adamcatley/LAZEY-Projector/Hardware/hardware.txt

Files related to hardware for the project.
eg. schematics and baord designs
