adamcatley/LAZEY-Projector/Hardware/Controller/sch.brd

## EAGLE design Hardware/Controller/sch.brd (2014-09-18)

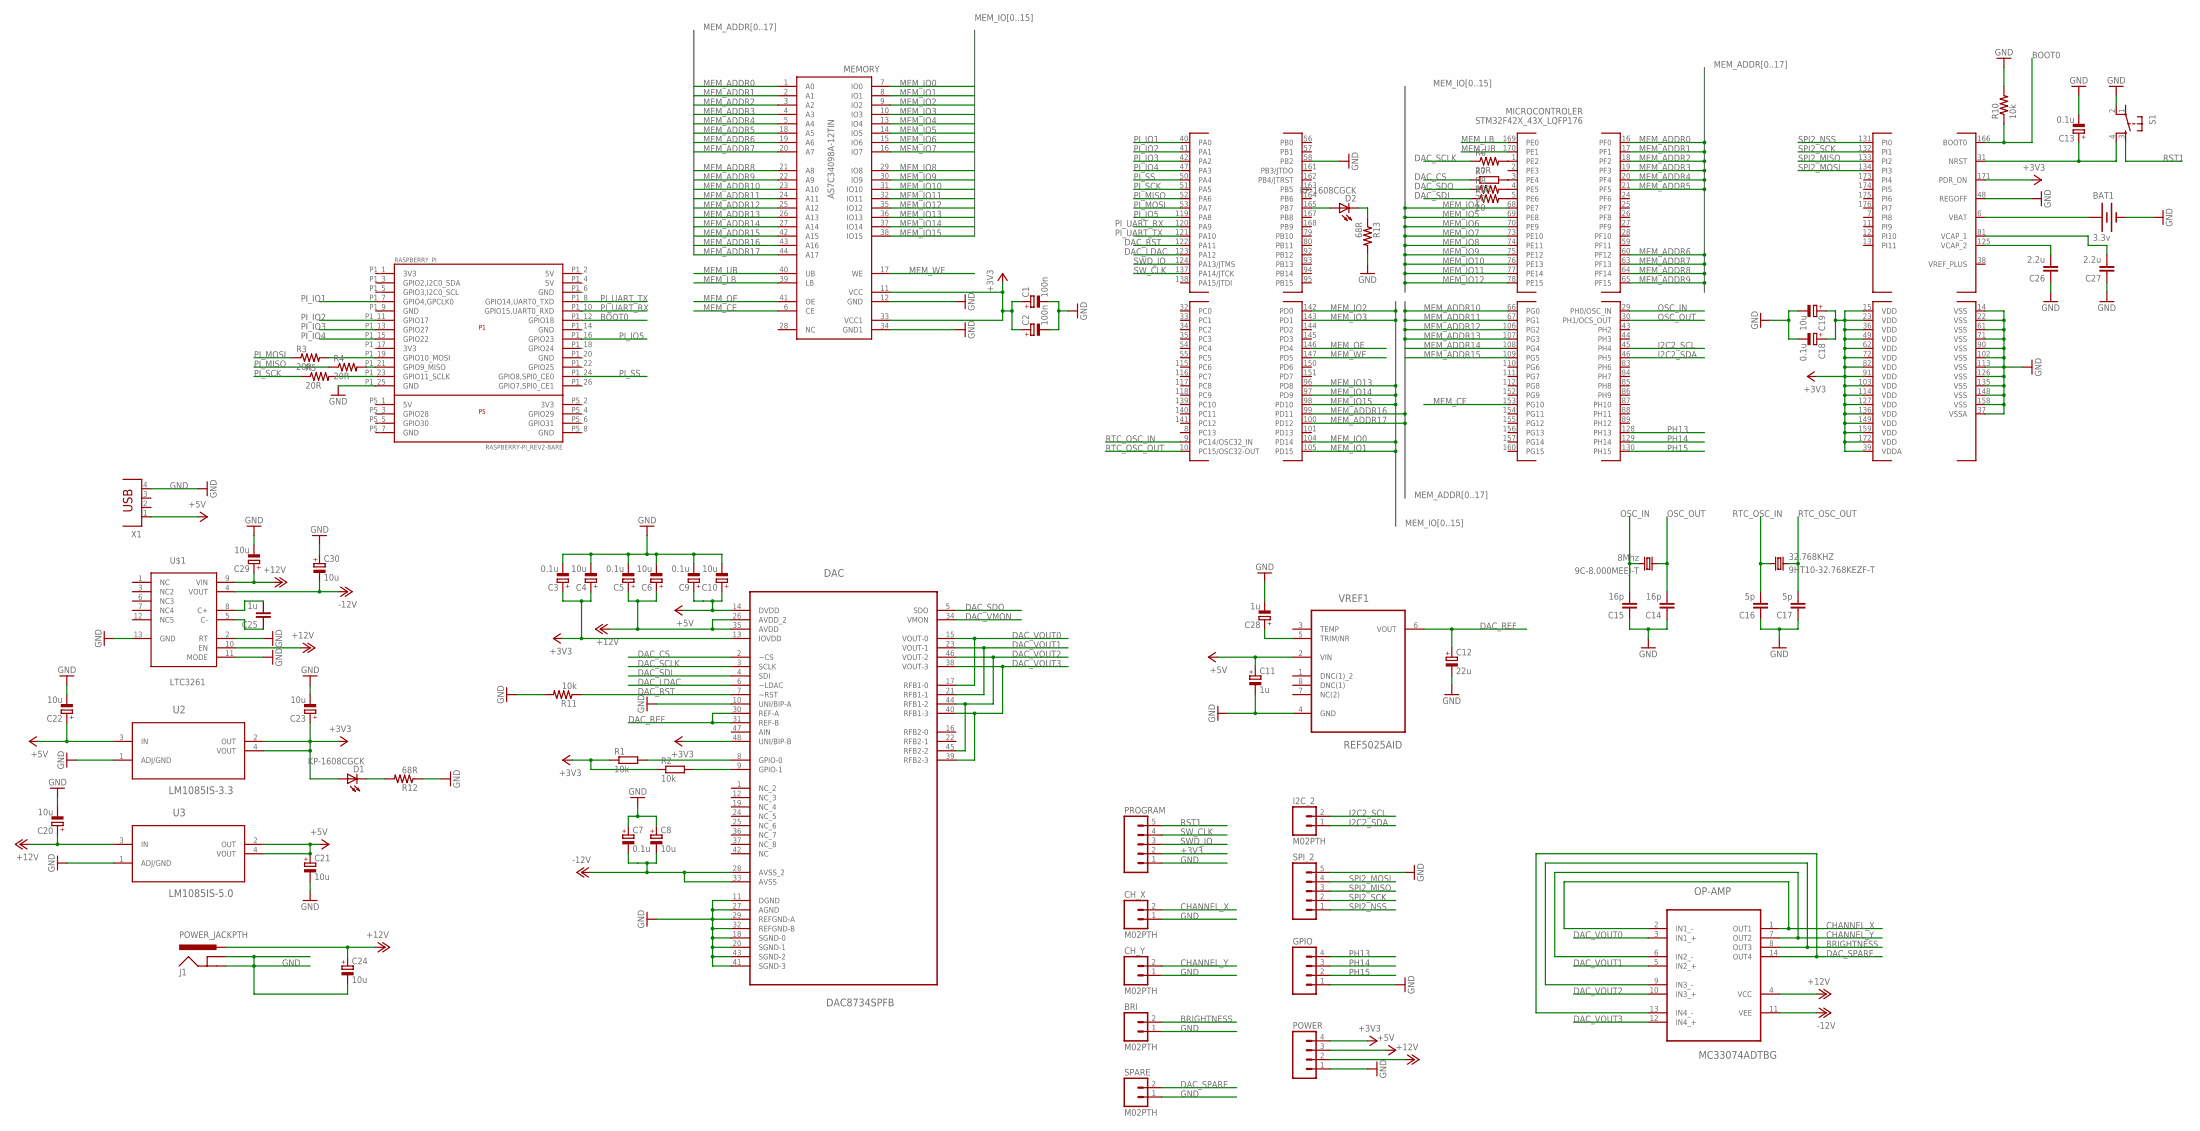
[picture p1: schematic sch.sch]

Parts:
9C-8.000MEEJ-T: 8Mhz; CSM-7X-DU
32.768KHZ: 9HT10-32.768KEZF-T
BAT1: 3.3v; BATTCON_12MM
BRI: M02PTH; 1X02
C1, C2: 100n; SMC_A
C3, C5, C7, C9, C13, C18: 0.1u; SMC_A
C4, C6, C8, C10, C19, C20, C21, C22, C23, C24, C29, C30: 10u; SMC_A
C11, C28: 1u; SMC_A
C12: 22u; SMC_A
C14, C15: 16p; C0603
C16, C17: 5p; C0603
C25: 1u; C0603
C26, C27: 2.2u; C0603
CH_X: M02PTH; 1X02
CH_Y: M02PTH; 1X02
D1, D2: KP-1608CGCK; LED-0603
DAC: DAC8734SPFB; QFP50P900X900X120-48N
GPIO: M04PTH; 1X04
I2C_2: M02PTH; 1X02
J1: POWER_JACKPTH; POWER_JACK_PTH
MEMORY: AS7C34098A-12TIN; TSOPII-44
MICROCONTROLER: STM32F42X_43X_LQFP176; LQFP176_PACKAGE
OP-AMP: MC33074ADTBG; SOP65P640X120-14N
POWER: M04PTH; 1X04
PROGRAM: M05PTH; 1X05
R1, R2: 10k; R0805
R3, R4, R5, R6: 20R; 0603-RES
R7: 20R; R0603
R8, R9: 20; 0603-RES
R10, R11: 10k; 0603-RES
R12, R13: 68R; 0603-RES
RASPBERRY_PI: RASPBERRY-PI_REV2-BARE
S1: TAC_SWITCHSMD; TACTILE_SWITCH_SMD
SPARE: M02PTH; 1X02
SPI_2: M05PTH; 1X05
U2: LM1085IS-3.3; TO254P1435X457-3N
U3: LM1085IS-5.0; TO254P1435X457-3N
U$1: LTC3261; MSOP12
VREF1: REF5025AID; SOIC127P600X175-8N
X1: PN87520

Connections:
+3V3: C1.+, C2.+, C3.+, C4.+, C18.+, C19.+, C23.+, D1.A, DAC.13 (IOVDD), DAC.48 (UNI/BIP-B), MEMORY.11 (VCC), MEMORY.33 (VCC1), MICROCONTROLER.15 (VDD), MICROCONTROLER.23 (VDD), MICROCONTROLER.36 (VDD), MICROCONTROLER.39 (VDDA), MICROCONTROLER.49 (VDD), MICROCONTROLER.62 (VDD), MICROCONTROLER.72 (VDD), MICROCONTROLER.82 (VDD), MICROCONTROLER.91 (VDD), MICROCONTROLER.103 (VDD), MICROCONTROLER.114 (VDD), MICROCONTROLER.127 (VDD), MICROCONTROLER.136 (VDD), MICROCONTROLER.149 (VDD), MICROCONTROLER.159 (VDD), MICROCONTROLER.171 (PDR_ON), MICROCONTROLER.172 (VDD), POWER.4, PROGRAM.2, R1.1, R2.1, U2.2 (OUT), U2.4 (VOUT)
+5V: C9.+, C10.+, C11.+, C21.+, C22.+, DAC.14 (DVDD), POWER.3, U2.3 (IN), U3.2 (OUT), U3.4 (VOUT), VREF1.2 (VIN), X1.1
+12V: C5.+, C6.+, C20.+, C24.+, C29.+, DAC.26 (AVDD_2), DAC.35 (AVDD), J1.PWR, OP-AMP.4 (VCC), POWER.2, U3.3 (IN), U$1.9 (VIN), U$1.10 (EN)
-12V: C7.-, C8.-, C30.-, DAC.28 (AVSS_2), DAC.33 (AVSS), OP-AMP.11 (VEE), U$1.4 (VOUT)
BOOT0: MICROCONTROLER.166 (BOOT0), R10.1, RASPBERRY_PI.P1_12 (GPIO18)
BRIGHTNESS: BRI.2, OP-AMP.8 (OUT3), OP-AMP.9 (IN3_-)
CHANNEL_X: CH_X.2, OP-AMP.1 (OUT1), OP-AMP.2 (IN1_-)
CHANNEL_Y: CH_Y.2, OP-AMP.6 (IN2_-), OP-AMP.7 (OUT2)
DAC_CS: DAC.2 (~CS), R7.1
DAC_LDAC: DAC.6 (~LDAC), MICROCONTROLER.123 (PA12)
DAC_REF: C12.+, DAC.30 (REF-A), DAC.31 (REF-B), VREF1.6 (VOUT)
DAC_RST: DAC.7 (~RST), MICROCONTROLER.122 (PA11), R11.1
DAC_SCLK: DAC.3 (SCLK), R6.1
DAC_SDI: DAC.4 (SDI), R9.1
DAC_SDO: DAC.5 (SDO), R8.1
DAC_SPARE: OP-AMP.13 (IN4_-), OP-AMP.14 (OUT4), SPARE.2
DAC_VMON: DAC.34 (VMON)
DAC_VOUT0: DAC.15 (VOUT-0), DAC.17 (RFB1-0), OP-AMP.3 (IN1_+)
DAC_VOUT1: DAC.21 (RFB1-1), DAC.23 (VOUT-1), OP-AMP.5 (IN2_+)
DAC_VOUT2: DAC.44 (RFB1-2), DAC.45 (RFB2-2), DAC.46 (VOUT-2), OP-AMP.10 (IN3_+)
DAC_VOUT3: DAC.38 (VOUT-3), DAC.39 (RFB2-3), DAC.40 (RFB1-3), OP-AMP.12 (IN4_+)
GND: BAT1.GND (-), BRI.1, C1.-, C2.-, C3.-, C4.-, C5.-, C6.-, C7.+, C8.+, C9.-, C10.-, C11.-, C12.-, C13.-, C14.1, C15.1, C16.1, C17.1, C18.-, C19.-, C20.-, C21.-, C22.-, C23.-, C24.-, C26.1, C27.1, C28.-, C29.-, C30.+, CH_X.1, CH_Y.1, DAC.10 (UNI/BIP-A), DAC.11 (DGND), DAC.18 (SGND-0), DAC.20 (SGND-1), DAC.27 (AGND), DAC.29 (REFGND-A), DAC.32 (REFGND-B), DAC.41 (SGND-3), DAC.43 (SGND-2), GPIO.1, J1.GND, J1.GNDBREAK, MEMORY.12 (GND), MEMORY.34 (GND1), MICROCONTROLER.14 (VSS), MICROCONTROLER.22 (VSS), MICROCONTROLER.37 (VSSA), MICROCONTROLER.48 (REGOFF), MICROCONTROLER.58 (PB2), MICROCONTROLER.61 (VSS), MICROCONTROLER.71 (VSS), MICROCONTROLER.90 (VSS), MICROCONTROLER.102 (VSS), MICROCONTROLER.113 (VSS), MICROCONTROLER.126 (VSS), MICROCONTROLER.135 (VSS), MICROCONTROLER.148 (VSS), MICROCONTROLER.158 (VSS), POWER.1, PROGRAM.1, R10.2, R11.2, R12.1, R13.2, RASPBERRY_PI.P1_25 (GND), S1.2, SPARE.1, SPI_2.5, U2.1 (ADJ/GND), U3.1 (ADJ/GND), U$1.2 (RT), U$1.11 (MODE), U$1.13 (GND), VREF1.4 (GND), X1.4
I2C2_SCL: I2C_2.2, MICROCONTROLER.45 (PH4)
I2C2_SDA: I2C_2.1, MICROCONTROLER.46 (PH5)
MEM_ADDR0: MEMORY.1 (A0), MICROCONTROLER.16 (PF0)
MEM_ADDR1: MEMORY.2 (A1), MICROCONTROLER.17 (PF1)
MEM_ADDR2: MEMORY.3 (A2), MICROCONTROLER.18 (PF2)
MEM_ADDR3: MEMORY.4 (A3), MICROCONTROLER.19 (PF3)
MEM_ADDR4: MEMORY.5 (A4), MICROCONTROLER.20 (PF4)
MEM_ADDR5: MEMORY.18 (A5), MICROCONTROLER.21 (PF5)
MEM_ADDR6: MEMORY.19 (A6), MICROCONTROLER.60 (PF12)
MEM_ADDR7: MEMORY.20 (A7), MICROCONTROLER.63 (PF13)
MEM_ADDR8: MEMORY.21 (A8), MICROCONTROLER.64 (PF14)
MEM_ADDR9: MEMORY.22 (A9), MICROCONTROLER.65 (PF15)
MEM_ADDR10: MEMORY.23 (A10), MICROCONTROLER.66 (PG0)
MEM_ADDR11: MEMORY.24 (A11), MICROCONTROLER.67 (PG1)
MEM_ADDR12: MEMORY.25 (A12), MICROCONTROLER.106 (PG2)
MEM_ADDR13: MEMORY.26 (A13), MICROCONTROLER.107 (PG3)
MEM_ADDR14: MEMORY.27 (A14), MICROCONTROLER.108 (PG4)
MEM_ADDR15: MEMORY.42 (A15), MICROCONTROLER.109 (PG5)
MEM_ADDR16: MEMORY.43 (A16), MICROCONTROLER.99 (PD11)
MEM_ADDR17: MEMORY.44 (A17), MICROCONTROLER.100 (PD12)
MEM_CE: MEMORY.6 (CE), MICROCONTROLER.153 (PG10)
MEM_IO0: MEMORY.7 (IO0), MICROCONTROLER.104 (PD14)
MEM_IO1: MEMORY.8 (IO1), MICROCONTROLER.105 (PD15)
MEM_IO2: MEMORY.9 (IO2), MICROCONTROLER.142 (PD0)
MEM_IO3: MEMORY.10 (IO3), MICROCONTROLER.143 (PD1)
MEM_IO4: MEMORY.13 (IO4), MICROCONTROLER.68 (PE7)
MEM_IO5: MEMORY.14 (IO5), MICROCONTROLER.69 (PE8)
MEM_IO6: MEMORY.15 (IO6), MICROCONTROLER.70 (PE9)
MEM_IO7: MEMORY.16 (IO7), MICROCONTROLER.73 (PE10)
MEM_IO8: MEMORY.29 (IO8), MICROCONTROLER.74 (PE11)
MEM_IO9: MEMORY.30 (IO9), MICROCONTROLER.75 (PE12)
MEM_IO10: MEMORY.31 (IO10), MICROCONTROLER.76 (PE13)
MEM_IO11: MEMORY.32 (IO11), MICROCONTROLER.77 (PE14)
MEM_IO12: MEMORY.35 (IO12), MICROCONTROLER.78 (PE15)
MEM_IO13: MEMORY.36 (IO13), MICROCONTROLER.96 (PD8)
MEM_IO14: MEMORY.37 (IO14), MICROCONTROLER.97 (PD9)
MEM_IO15: MEMORY.38 (IO15), MICROCONTROLER.98 (PD10)
MEM_LB: MEMORY.39 (LB), MICROCONTROLER.169 (PE0)
MEM_OE: MEMORY.41 (OE), MICROCONTROLER.146 (PD4)
MEM_UB: MEMORY.40 (UB), MICROCONTROLER.170 (PE1)
MEM_WE: MEMORY.17 (WE), MICROCONTROLER.147 (PD5)
unnamed: DAC.8 (GPIO-0), R1.2
unnamed: DAC.9 (GPIO-1), R2.2
unnamed: D1.C, R12.2
unnamed: D2.A, MICROCONTROLER.165 (PB7)
unnamed: R3.2, RASPBERRY_PI.P1_19 (GPIO10_MOSI)
unnamed: C25.2, U$1.8 (C+)
unnamed: R4.2, RASPBERRY_PI.P1_21 (GPIO9_MISO)
unnamed: R5.2, RASPBERRY_PI.P1_23 (GPIO11_SCLK)
unnamed: MICROCONTROLER.5 (PE6), R9.2
unnamed: MICROCONTROLER.4 (PE5), R8.2
unnamed: MICROCONTROLER.3 (PE4), R7.2
unnamed: MICROCONTROLER.1 (PE2), R6.2
unnamed: C25.1, U$1.5 (C-)
unnamed: D2.C, R13.1
unnamed: C26.2, MICROCONTROLER.125 (VCAP_2)
unnamed: C27.2, MICROCONTROLER.81 (VCAP_1)
unnamed: C28.+, VREF1.5 (TRIM/NR)
OSC_IN: 9C-8.000MEEJ-T.2, C15.2, MICROCONTROLER.29 (PH0/OSC_IN)
OSC_OUT: 9C-8.000MEEJ-T.1, C14.2, MICROCONTROLER.30 (PH1/OCS_OUT)
PH13: GPIO.4, MICROCONTROLER.128 (PH13)
PH14: GPIO.3, MICROCONTROLER.129 (PH14)
PH15: GPIO.2, MICROCONTROLER.130 (PH15)
PI_IO1: MICROCONTROLER.40 (PA0), RASPBERRY_PI.P1_7 (GPIO4,GPCLK0)
PI_IO2: MICROCONTROLER.41 (PA1), RASPBERRY_PI.P1_11 (GPIO17)
PI_IO3: MICROCONTROLER.42 (PA2), RASPBERRY_PI.P1_13 (GPIO27)
PI_IO4: MICROCONTROLER.47 (PA3), RASPBERRY_PI.P1_15 (GPIO22)
PI_IO5: MICROCONTROLER.119 (PA8), RASPBERRY_PI.P1_16 (GPIO23)
PI_MISO: MICROCONTROLER.52 (PA6), R4.1
PI_MOSI: MICROCONTROLER.53 (PA7), R3.1
PI_SCK: MICROCONTROLER.51 (PA5), R5.1
PI_SS: MICROCONTROLER.50 (PA4), RASPBERRY_PI.P1_24 (GPIO8,SPI0_CE0)
PI_UART_RX: MICROCONTROLER.120 (PA9), RASPBERRY_PI.P1_10 (GPIO15,UART0_RXD)
PI_UART_TX: MICROCONTROLER.121 (PA10), RASPBERRY_PI.P1_8 (GPIO14,UART0_TXD)
RST0: C13.+, MICROCONTROLER.31 (NRST), S1.4
RST1: PROGRAM.5, S1.3
RTC_OSC_IN: 32.768KHZ.P$1 (1), C16.2, MICROCONTROLER.9 (PC14/OSC32_IN)
RTC_OSC_OUT: 32.768KHZ.P$2 (2), C17.2, MICROCONTROLER.10 (PC15/OSC32-OUT)
SPI2_MISO: MICROCONTROLER.133 (PI2), SPI_2.3
SPI2_MOSI: MICROCONTROLER.134 (PI3), SPI_2.4
SPI2_NSS: MICROCONTROLER.131 (PI0), SPI_2.1
SPI2_SCK: MICROCONTROLER.132 (PI1), SPI_2.2
SWD_IO: MICROCONTROLER.124 (PA13/JTMS), PROGRAM.3
SW_CLK: MICROCONTROLER.137 (PA14/JTCK), PROGRAM.4
VBAT: BAT1.PWR@1 (+), MICROCONTROLER.6 (VBAT)

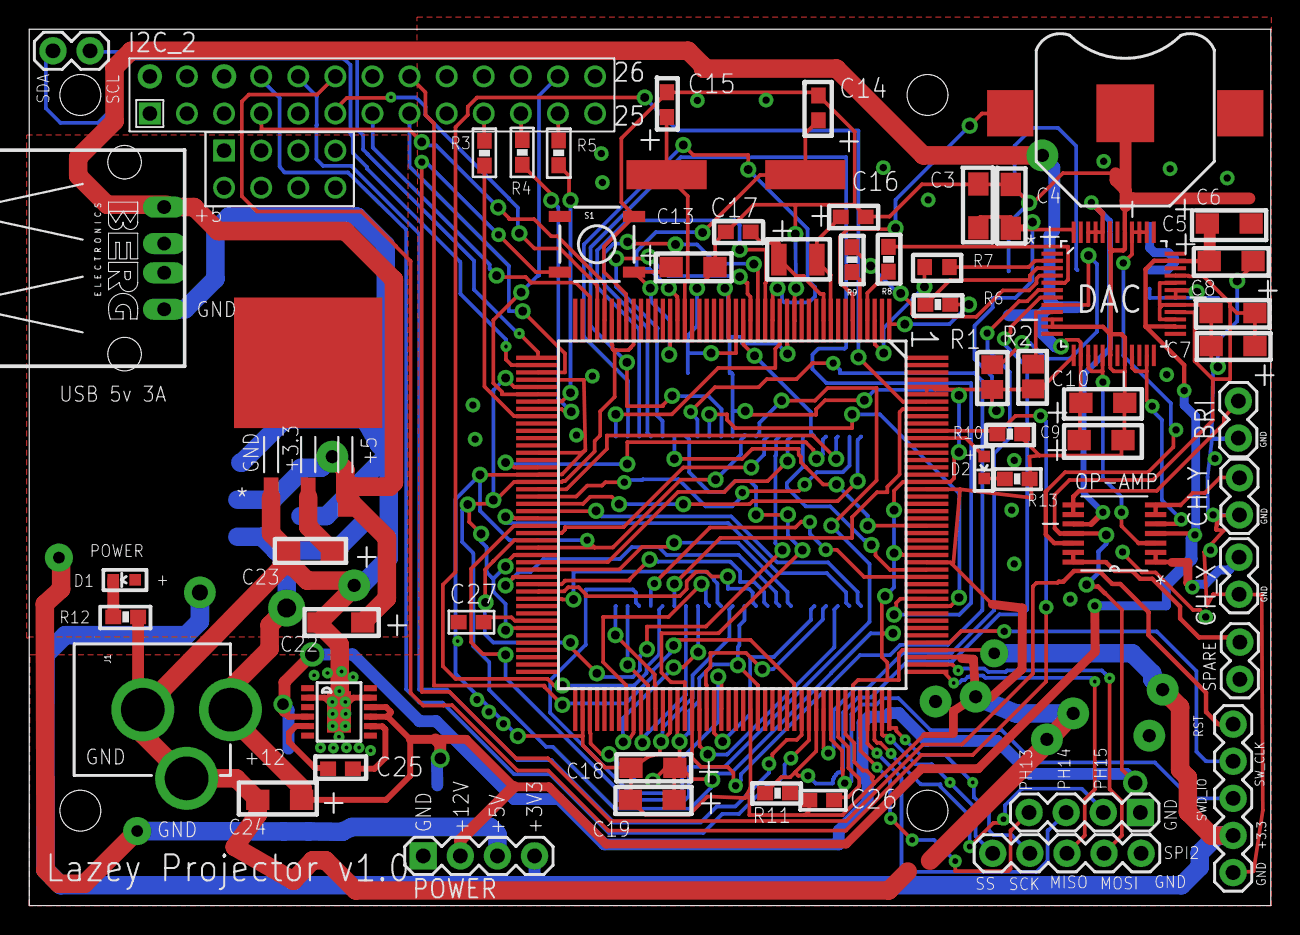
[picture p2: board Hardware/Controller/sch.brd from above]

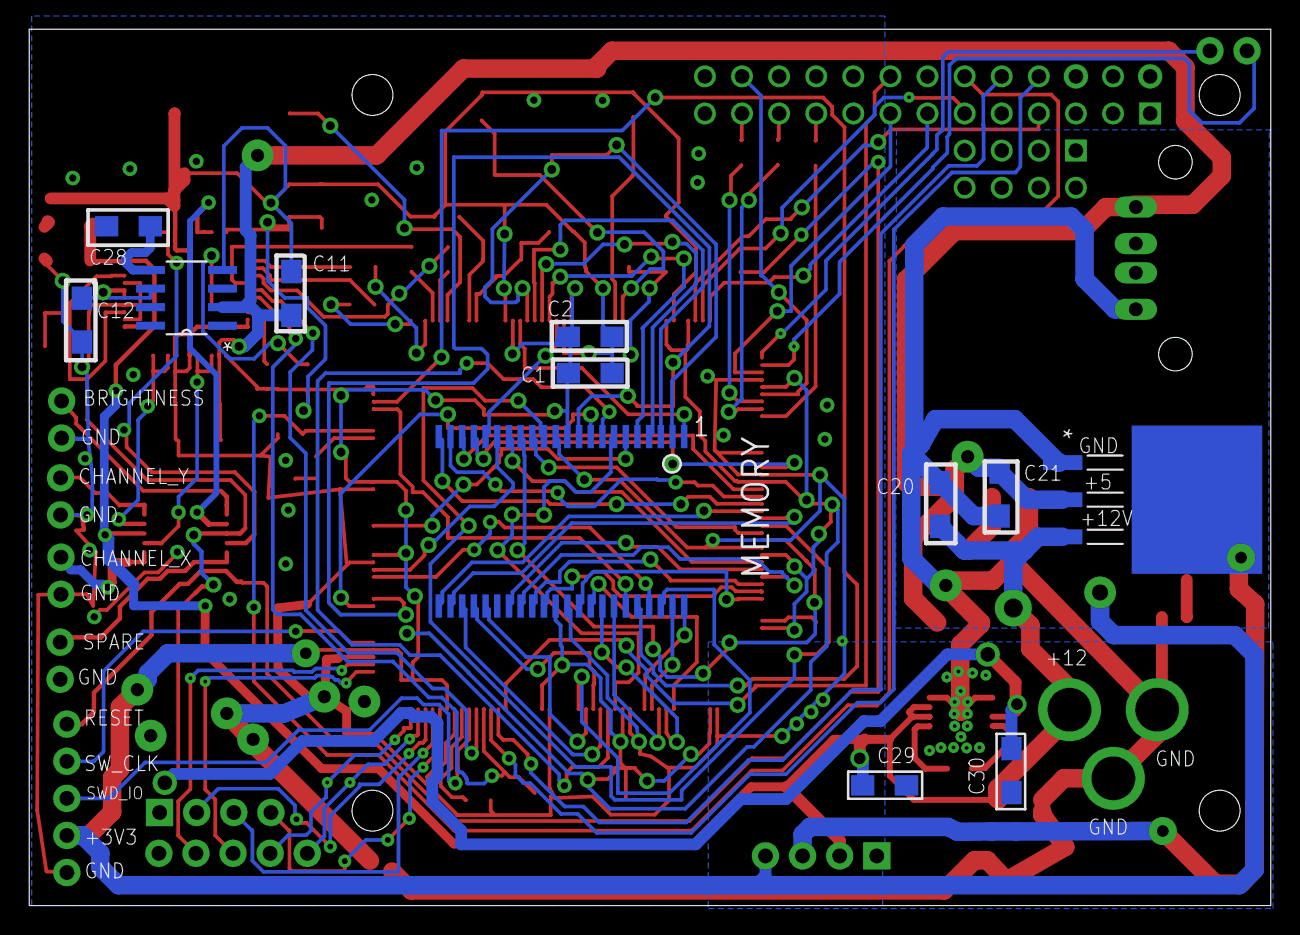
[picture p3: board Hardware/Controller/sch.brd from below]

Board: 2 copper layers, 85.0 x 60.0 mm, 69 parts (12 on the bottom side), 106 nets.
