adamcatley/LAZEY-Projector/Hardware/Laser Driver/Sch.brd

## EAGLE design Hardware/Laser Driver/Sch.brd (2014-09-18, an earlier design)

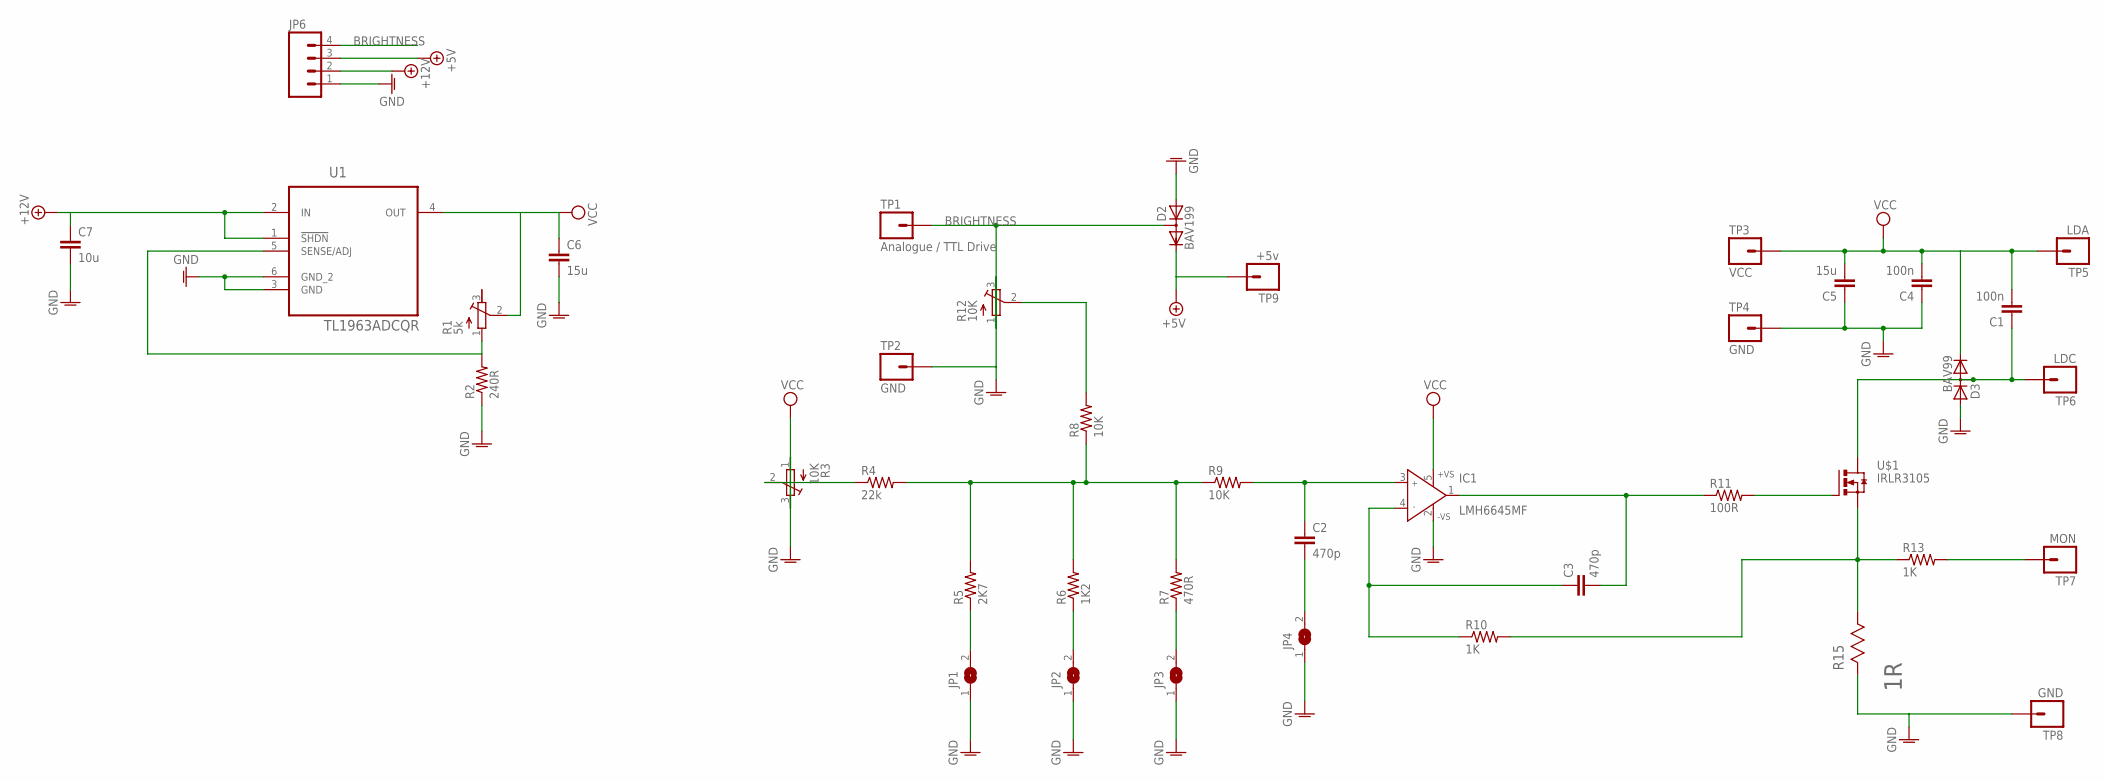
[picture p4: schematic Sch.sch]

Parts:
C1, C4: 100n; 1206
C2, C3: 470p; 1206
C5, C6: 15u; 1206
C7: 10u; 1206
D2: BAV199; SOT23
D3: BAV99; SOT23
IC1: LMH6645MF; SOT23-5
JP1, JP2, JP3, JP4: SJ
JP6: M04PTH; 1X04
R1: 5k; RTRIM64W
R2: 240R; 0603-RES
R3, R12: 10K; RTRIM5X
R4: 22k; 0603-RES
R5: 2K7; 0603-RES
R6: 1K2; 0603-RES
R7: 470R; 0603-RES
R8, R9: 10K; 0603-RES
R10, R13: 1K; 0603-RES
R11: 100R; R0603
R15: 1R; RESC5025X71N
TP1: Analogue / TTL Drive; 1X01
TP2, TP4, TP8: GND; 1X01
TP3: VCC; 1X01
TP5: LDA; 1X01_LONGPAD
TP6: LDC; 1X01_LONGPAD
TP7: MON; 1X01
TP9: +5v; 1X01
U1: TL1963ADCQR; SOT127P700X180-6N
U$1: IRLR3105; TO252AA-LARGE

Connections:
+5V: D2.2 (C), JP6.3, TP9.1
+12V: C7.1, JP6.2, U1.1 (!SHDN), U1.2 (IN)
BRIGHTNESS: D2.3 (AC), JP6.4, R12.1 (E), TP1.1
GNDA: C4.1, C5.1, C6.2, C7.2, D2.1 (A), D3.1 (A), IC1.2 (-VS), JP1.1, JP2.1, JP3.1, JP4.1, JP6.1, R2.1, R3.1 (E), R12.3 (A), R15.2 (R2), TP2.1, TP4.1, TP8.1, U1.3 (GND), U1.6 (GND_2)
unnamed: R8.2, R12.2 (S)
unnamed: R3.2 (S), R4.1
unnamed: R4.2, R5.2, R6.2, R7.2, R8.1, R9.1
unnamed: JP1.2, R5.1
unnamed: JP2.2, R6.1
unnamed: JP3.2, R7.1
unnamed: C2.2, JP4.2
unnamed: C2.1, IC1.3 (IN+), R9.2
unnamed: C3.1, IC1.4 (IN-), R10.1
unnamed: C3.2, IC1.1 (OUT), R11.1
unnamed: R11.2, U$1.P$1 (G)
unnamed: C1.1, D3.3 (AC), TP6.1, U$1.P$3 (D)
unnamed: R10.2, R13.1, R15.1 (R1), U$1.P$2 (S)
unnamed: R1.1 (E), R2.2, U1.5 (SENSE/ADJ)
unnamed: R13.2, TP7.1
VCC: C1.2, C4.2, C5.2, C6.1, D3.2 (C), IC1.5 (+VS), R1.2 (S), R3.3 (A), TP3.1, TP5.1, U1.4 (OUT)

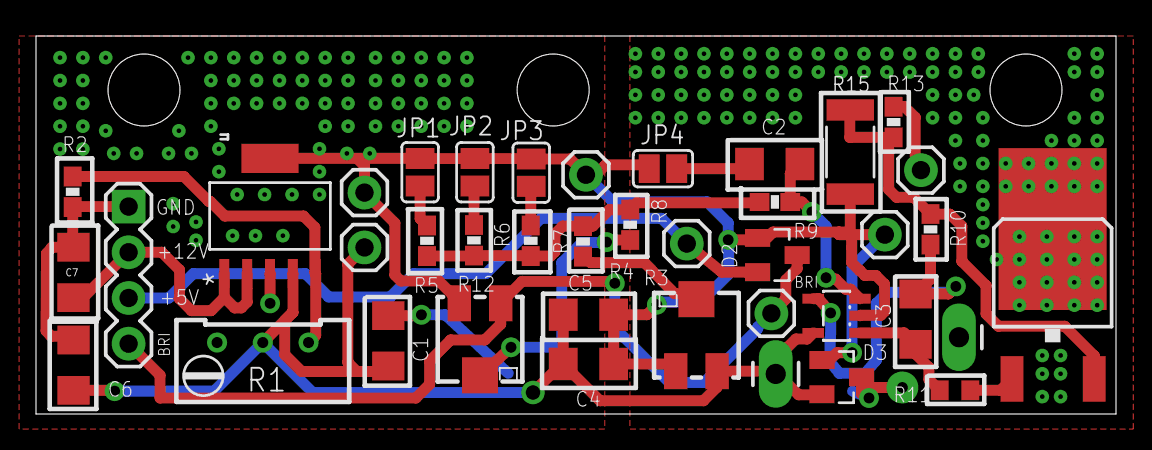
[picture p5: board Hardware/Laser Driver/Sch.brd from above]

Board: 2 copper layers, 60.0 x 21.0 mm, 40 parts (0 on the bottom side), 20 nets.
