adamcatley/LAZEY-Projector/Software/Raspberry Pi/LAZEY Library/alphabet.h

point alphabet[150][30] = { 
{ point(0, 0, 0, 0), point(0, 0, 0, 0), point(0, 0, 0, 0), point(0, 0, 0, 0), point(0, 0, 0, 0), point(0, 0, 0, 0), point(0, 0, 0, 0), point(0, 0, 0, 0), point(0, 0, 0, 0), point(0, 0, 0, 0), point(0, 0, 0, 0), point(0, 0, 0, 0), point(0, 0, 0, 0), point(0, 0, 0, 0), point(0, 0, 0, 0), point(0, 0, 0, 0), point(0, 0, 0, 0), point(0, 0, 0, 0), point(0, 0, 0, 0), point(0, 0, 0, 0), point(0, 0, 0, 0), point(0, 0, 0, 0), point(0, 0, 0, 0), point(0, 0, 0, 0), point(0, 0, 0, 0), point(0, 0, 0, 0), point(0, 0, 0, 0), point(0, 0, 0, 0), point(0, 0, 0, 0), point(0, 0, 0, 0)}, 
{ point(0, 0, 0, 0), point(0, 0, 0, 0), point(0, 0, 0, 0), point(0, 0, 0, 0), point(0, 0, 0, 0), point(0, 0, 0, 0), point(0, 0, 0, 0), point(0, 0, 0, 0), point(0, 0, 0, 0), point(0, 0, 0, 0), point(0, 0, 0, 0), point(0, 0, 0, 0), point(0, 0, 0, 0), point(0, 0, 0, 0), point(0, 0, 0, 0), point(0, 0, 0, 0), point(0, 0, 0, 0), point(0, 0, 0, 0), point(0, 0, 0, 0), point(0, 0, 0, 0), point(0, 0, 0, 0), point(0, 0, 0, 0), point(0, 0, 0, 0), point(0, 0, 0, 0), point(0, 0, 0, 0), point(0, 0, 0, 0), point(0, 0, 0, 0), point(0, 0, 0, 0), point(0, 0, 0, 0), point(0, 0, 0, 0)}, 
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
};
