adamcatley/LAZEY-Projector/Software/Raspberry Pi/Tetris/Shapes.h

/*
 * All the pieces
 *
 *  X, Y as top left 0,0
 *  [piece][rotation][X][Y]
 *
 *
*/

bool pieces[7][4][4][4] = {


	{ { {0,0,0,0},
		{0,1,1,0},
		{0,1,1,0},
		{0,0,0,0}
	}, { {0,0,0,0},
		{0,1,1,0},
		{0,1,1,0},
		{0,0,0,0}
	}, { {0,0,0,0},
		{0,1,1,0},
		{0,1,1,0},
		{0,0,0,0}
	}, { {0,0,0,0},
		{0,1,1,0},
		{0,1,1,0},
		{0,0,0,0}
	}},

	{ { {0,0,0,0},
		{1,1,1,1},
		{0,0,0,0},
		{0,0,0,0}
	}, { {0,0,1,0},
		{0,0,1,0},
		{0,0,1,0},
		{0,0,1,0}
	}, { {0,0,0,0},
		{1,1,1,1},
		{0,0,0,0},
		{0,0,0,0}
	}, { {0,0,1,0},
		{0,0,1,0},
		{0,0,1,0},
		{0,0,1,0}
	}},

	{ { {0,0,0,0},
		{0,0,1,1},
		{0,1,1,0},
		{0,0,0,0}
	}, { {0,0,1,0},
		{0,0,1,1},
		{0,0,0,1},
		{0,0,0,0}
	}, { {0,0,0,0},
		{0,0,1,1},
		{0,1,1,0},
		{0,0,0,0}
	}, { {0,0,1,0},
		{0,0,1,1},
		{0,0,0,1},
		{0,0,0,0}
	}},

	{ { {0,0,0,0},
		{0,1,1,0},
		{0,0,1,1},
		{0,0,0,0}
	}, { {0,0,0,1},
		{0,0,1,1},
		{0,0,1,0},
		{0,0,0,0}
	}, { {0,0,0,0},
		{0,1,1,0},
		{0,0,1,1},
		{0,0,0,0}
	}, { {0,0,0,1},
		{0,0,1,1},
		{0,0,1,0},
		{0,0,0,0}
	}},

	{ { {0,0,0,0},
		{0,1,1,1},
		{0,1,0,0},
		{0,0,0,0}
	}, { {0,0,1,0},
		{0,0,1,0},
		{0,0,1,1},
		{0,0,0,0}
	}, { {0,0,0,1},
		{0,1,1,1},
		{0,0,0,0},
		{0,0,0,0}
	}, { {0,1,1,0},
		{0,0,1,0},
		{0,0,1,0},
		{0,0,0,0}
	}},

	{ { {0,0,0,0},
		{0,1,1,1},
		{0,0,0,1},
		{0,0,0,0}
	}, { {0,0,1,1},
		{0,0,1,0},
		{0,0,1,0},
		{0,0,0,0}
	}, { {0,1,0,0},
		{0,1,1,1},
		{0,0,0,0},
		{0,0,0,0}
	}, { {0,0,1,0},
		{0,0,1,0},
		{0,1,1,0},
		{0,0,0,0}
	}},

	{ { {0,0,0,0},
		{0,1,1,1},
		{0,0,1,0},
		{0,0,0,0}
	}, { {0,0,1,0},
		{0,0,1,1},
		{0,0,1,0},
		{0,0,0,0}
	}, { {0,0,1,0},
		{0,1,1,1},
		{0,0,0,0},
		{0,0,0,0}
	}, { {0,0,1,0},
		{0,1,1,0},
		{0,0,1,0},
		{0,0,0,0}
	}}

};
