adamcatley/LAZEY-Projector/Firmware/Inc/boot_screen.h

/**
  ******************************************************************************
  * @file    Templates/Inc/main.h 
  * @author  MCD Application Team
  * @version V1.1.0
  * @date    26-June-2014
  * @brief   Header for main.c module
  ******************************************************************************
  * @attention
  *
  * <h2><center>&copy; COPYRIGHT(c) 2014 STMicroelectronics</center></h2>
  *
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
  ******************************************************************************
  */
  
/* Define to prevent recursive inclusion -------------------------------------*/
#ifndef __BOOT_SCREEN_H
#define __BOOT_SCREEN_H

/* Includes ------------------------------------------------------------------*/
#include "stm32f4xx_hal.h"

#define BOOT_SCREEN_POINTS 0x003c2 //962 //length, not data size

const uint8_t boot_scren_data[] = {
0x0, 0x0, 0x23, 0x90, 0x5d, 0xe9,
0x0, 0xff, 0x23, 0x90, 0x5d, 0xe9,
0x0, 0xff, 0x16, 0x91, 0x5d, 0xe9,
0x0, 0xff, 0x5a, 0x92, 0x5d, 0xe9,
0x0, 0xff, 0x9e, 0x93, 0x5d, 0xe9,
0x0, 0xff, 0x91, 0x94, 0xff, 0xe9,
0x0, 0xff, 0x33, 0x95, 0xa1, 0xea,
0x0, 0xff, 0xd5, 0x95, 0x43, 0xeb,
0x0, 0xff, 0x77, 0x96, 0xe5, 0xeb,
0x0, 0xff, 0x19, 0x97, 0xd8, 0xec,
0x0, 0xff, 0x19, 0x97, 0x1c, 0xee,
0x0, 0xff, 0x19, 0x97, 0x60, 0xef,
0x0, 0xff, 0x19, 0x97, 0xa4, 0xf0,
0x0, 0xff, 0x19, 0x97, 0xe8, 0xf1,
0x0, 0xff, 0x19, 0x97, 0x2c, 0xf3,
0x0, 0xff, 0x19, 0x97, 0x70, 0xf4,
0x0, 0xff, 0x19, 0x97, 0xb4, 0xf5,
0x0, 0xff, 0x19, 0x97, 0xf8, 0xf6,
0x0, 0xff, 0x19, 0x97, 0x3c, 0xf8,
0x0, 0xff, 0x19, 0x97, 0x80, 0xf9,
0x0, 0xff, 0x19, 0x97, 0xc4, 0xfa,
0x0, 0xff, 0x19, 0x97, 0x8, 0xfc,
0x0, 0xff, 0x19, 0x97, 0x4c, 0xfd,
0x0, 0xff, 0x19, 0x97, 0x90, 0xfe,
0x0, 0xff, 0x19, 0x97, 0xd4, 0xff,
0x0, 0xff, 0x19, 0x97, 0x18, 0x1,
0x0, 0xff, 0x19, 0x97, 0x5c, 0x2,
0x0, 0xff, 0x19, 0x97, 0xa0, 0x3,
0x0, 0xff, 0x19, 0x97, 0xe4, 0x4,
0x0, 0xff, 0x19, 0x97, 0x28, 0x6,
0x0, 0xff, 0x19, 0x97, 0x6c, 0x7,
0x0, 0xff, 0x19, 0x97, 0xb0, 0x8,
0x0, 0xff, 0xc, 0x98, 0x52, 0x9,
0x0, 0xff, 0x50, 0x99, 0x52, 0x9,
0x0, 0xff, 0x94, 0x9a, 0x52, 0x9,
0x0, 0xff, 0xd8, 0x9b, 0x52, 0x9,
0x0, 0xff, 0x1c, 0x9d, 0x52, 0x9,
0x0, 0xff, 0x60, 0x9e, 0x52, 0x9,
0x0, 0xff, 0xa4, 0x9f, 0x52, 0x9,
0x0, 0xff, 0xe8, 0xa0, 0x52, 0x9,
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
};

#endif
