adamcatley/LAZEY-Projector/(commit log)

2014-06-20 Proposed Structure
    [Sch.brd, Sch.sch]
2014-06-20 Proposed Structure
    Folder structure for various project files
    [Sch.brd, Sch.sch]
2014-09-18 Added hardware and software files
    [Sch.brd, Sch.sch]
